Secalot/secalot.hardware/README.md

# Secalot Hardware

[Secalot](http://secalot.com) is a small USB dongle that carries four applications on board: a bitcoin wallet, an OpenPGP smart card, a U2F authenticator and a one time passwords generator.

This repository contains board designs for the [Secalot](http://secalot.com) dongle.

## Open With

Please use [KiCad](http://kicad-pcb.org/) to open the files.

## License

This project is licensed under the MIT License - see the [LICENSE](LICENSE) file for details.
