Secalot/secalot.hardware/BOM.xlsx

Manufacturer | Manufacturer Part Number | Designator | Qty | Description | Case | SMD ,BGA,LCC,OR TH | Top/Bottom | points | Total points | Comment
TE Connectivity | 1-1734028-1 | U1 | 1 | USB plug |  |  | Top | 4 | 4
NXP | MK82FN256VDC15 | U2 | 1 | Kinetis MCU | MAPBGA-121 | BGA | Top | 121 | 121
KEMET | C0603C104K8PACTU | C2,C3,C4,C5,C6,C7,C8 | 7 | 0.1 uF Capacitor | 0603 (inch) | SMD | Top | 2 | 14
KEMET | C0603C225K9PACTU | C1 | 1 | 2.2 uF Capacitor | 0603 (inch) | SMD | Top | 2 | 2
Vishay | CRCW060333R0JNEA | R1,R3 | 2 | 33 Ohms Resistor | 0603 (inch) | SMD | Top | 2 | 4
