Secalot/secalot.hardware/(commit log)

2017-05-17 Initial import
    [p1.kicad_pcb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]
2017-11-22 Add bom file. Change powering scheme, remove LED.
    [BOM.xlsx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]
